pmr7c9/OOS/README.md

# OOS
	OOS - optyczny odbiornik sygnałów
	Urządzenie do odbioru sygnału optycznego i konwersję na sygnał elektryczny.
