pmr7c9/OOS/Pictures/AOSS32334C_Static_Parameters.jpg

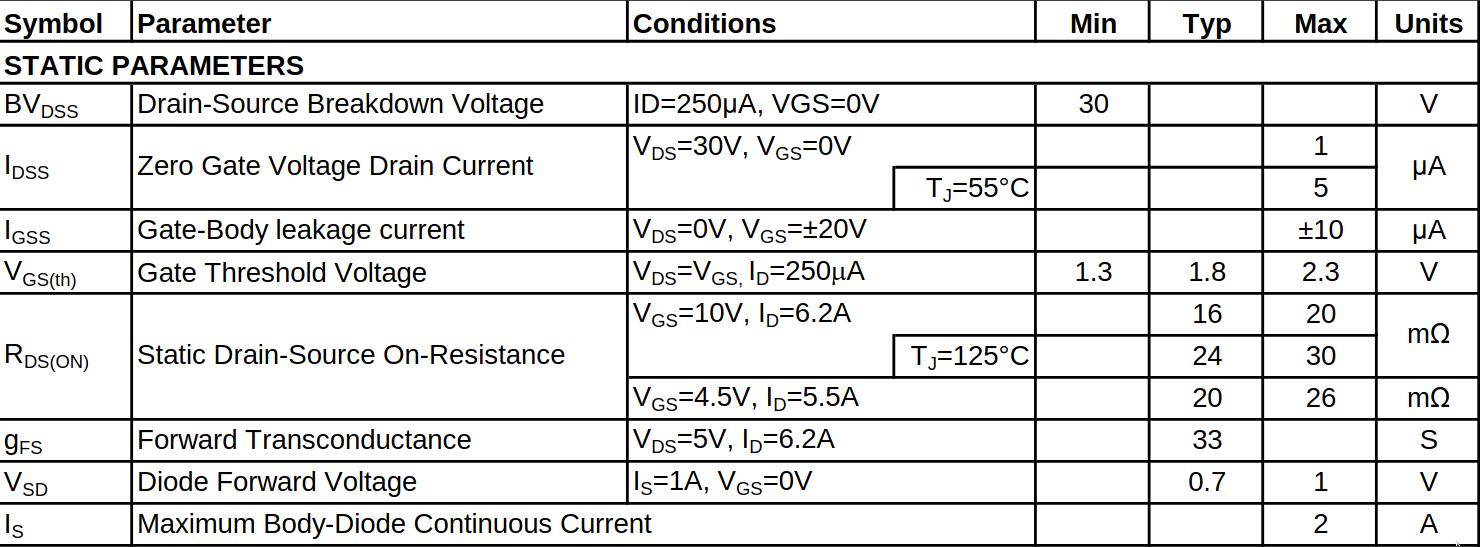
Pictures/AOSS32334C_Static_Parameters.jpg
