pmr7c9/OOS/Pictures/MCP73832_PROG.jpg

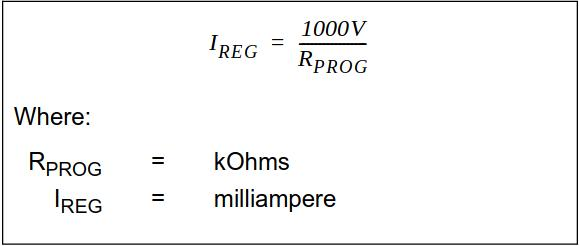
Pictures/MCP73832_PROG.jpg
