pmr7c9/OOS/OOS - optyczny odbiornik sygnalow/rotary_switch/SR17A1815F89N.stp

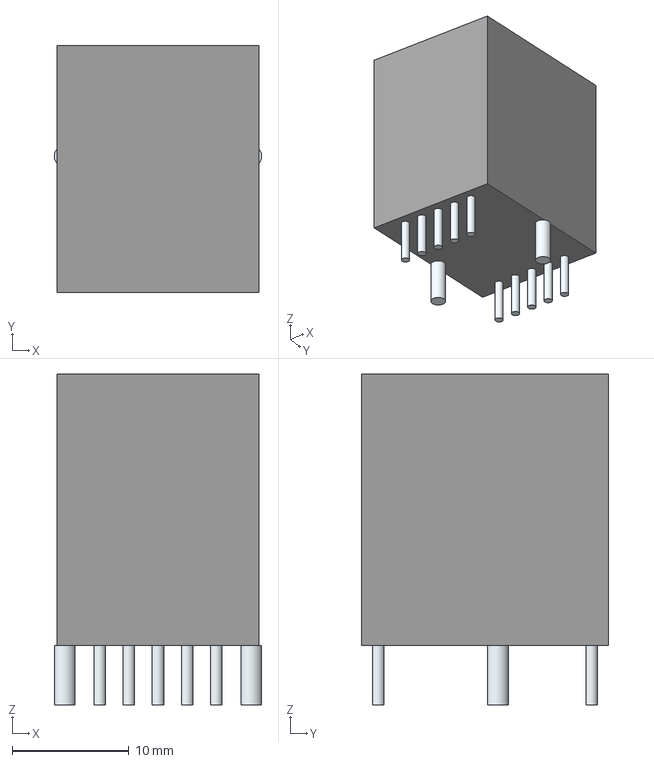
[picture p3: CAD file, 2025-11-27]
OOS - optyczny odbiornik sygnalow/rotary_switch/SR17A1815F89N.stp
17.8 x 21.2 x 28.4 mm
Leads x 12
