pmr7c9/OOS/OOS - optyczny odbiornik sygnalow/OOS - optyczny odbiornik sygnalow.kicad_pcb

## KiCad design OOS - optyczny odbiornik sygnalow/OOS - optyczny odbiornik sygnalow.kicad_pcb (2025-11-28)

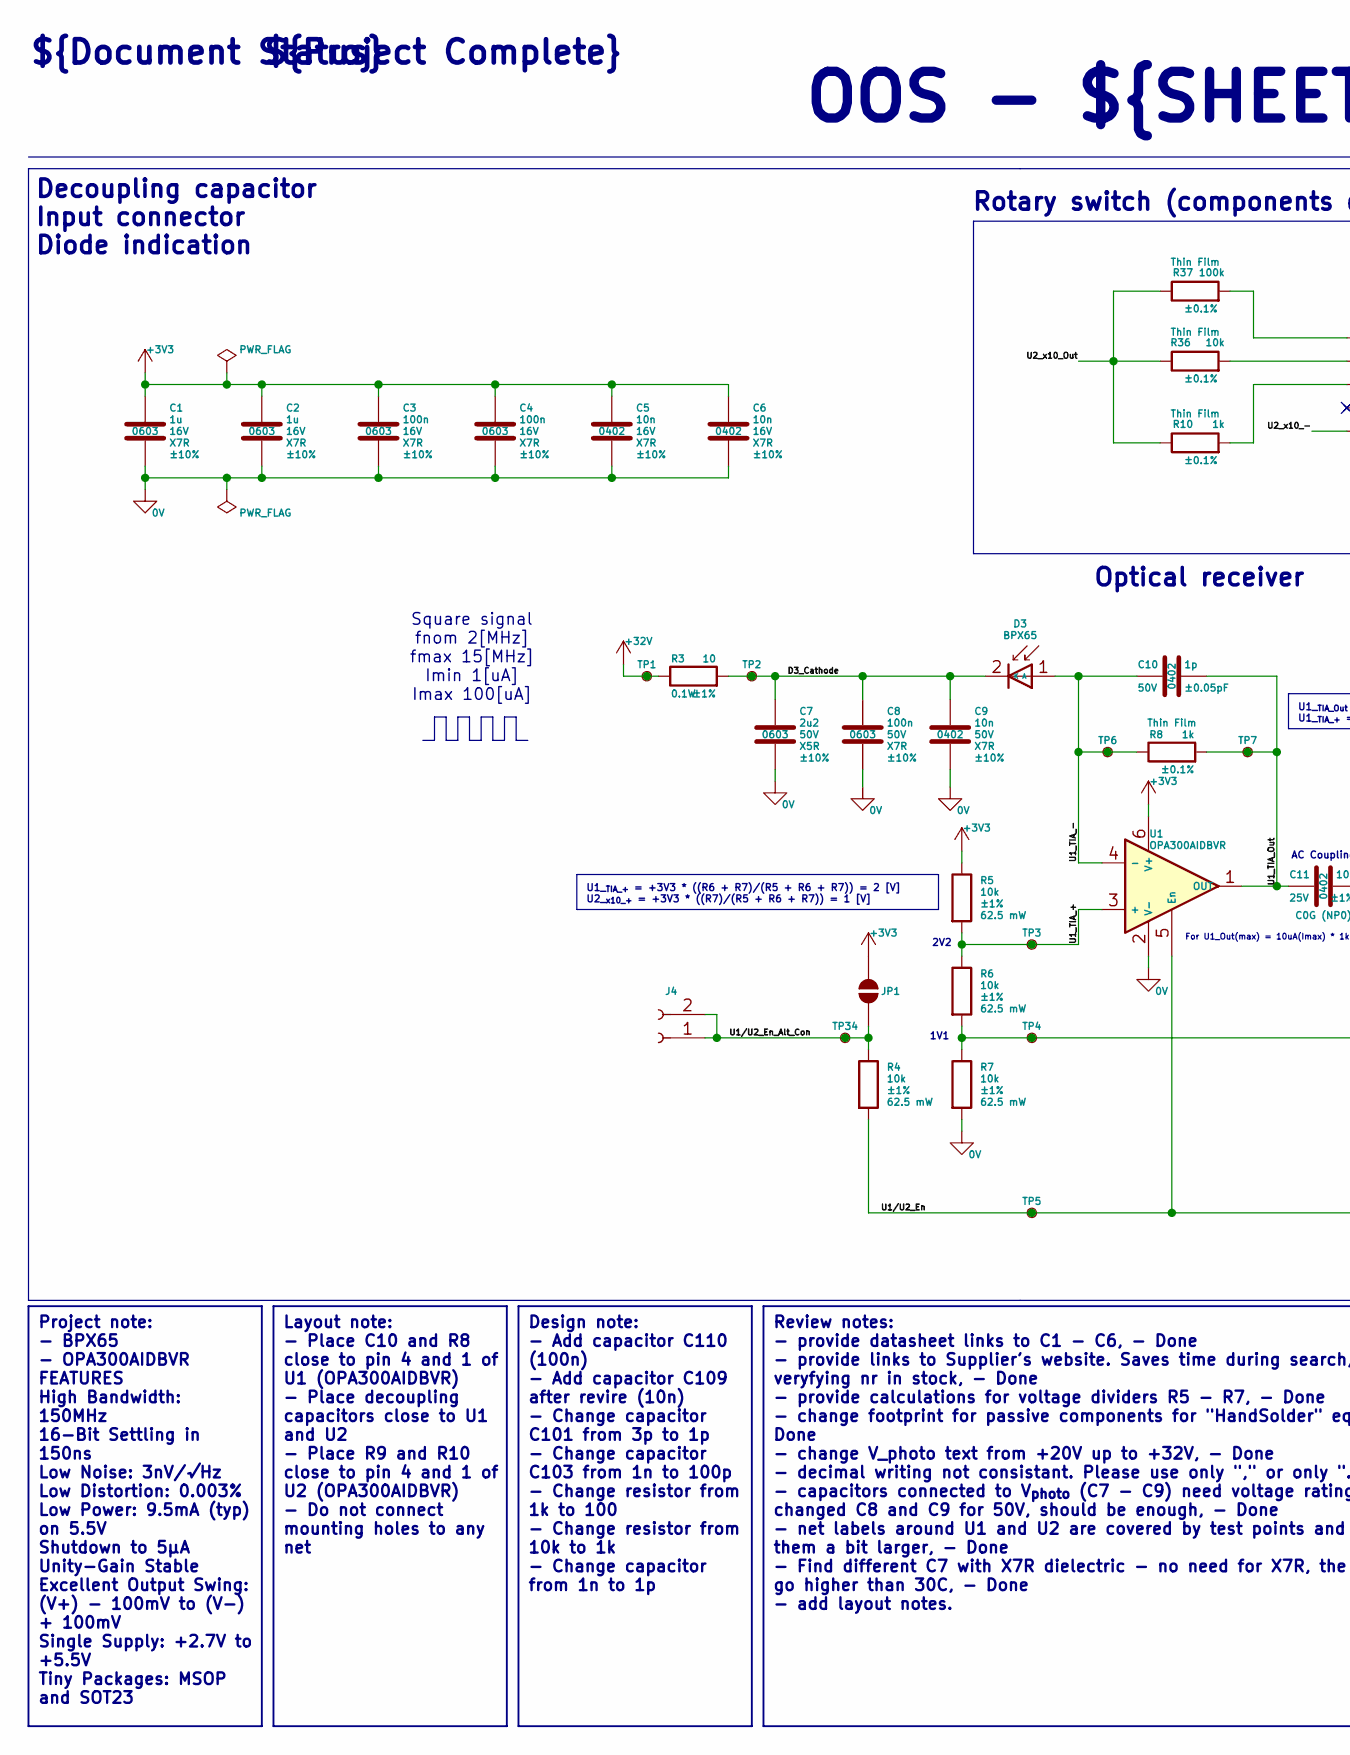
[picture p4: schematic Sekcja_Analogowa.kicad_sch, ${Project Title}, part in row 1, column 1]

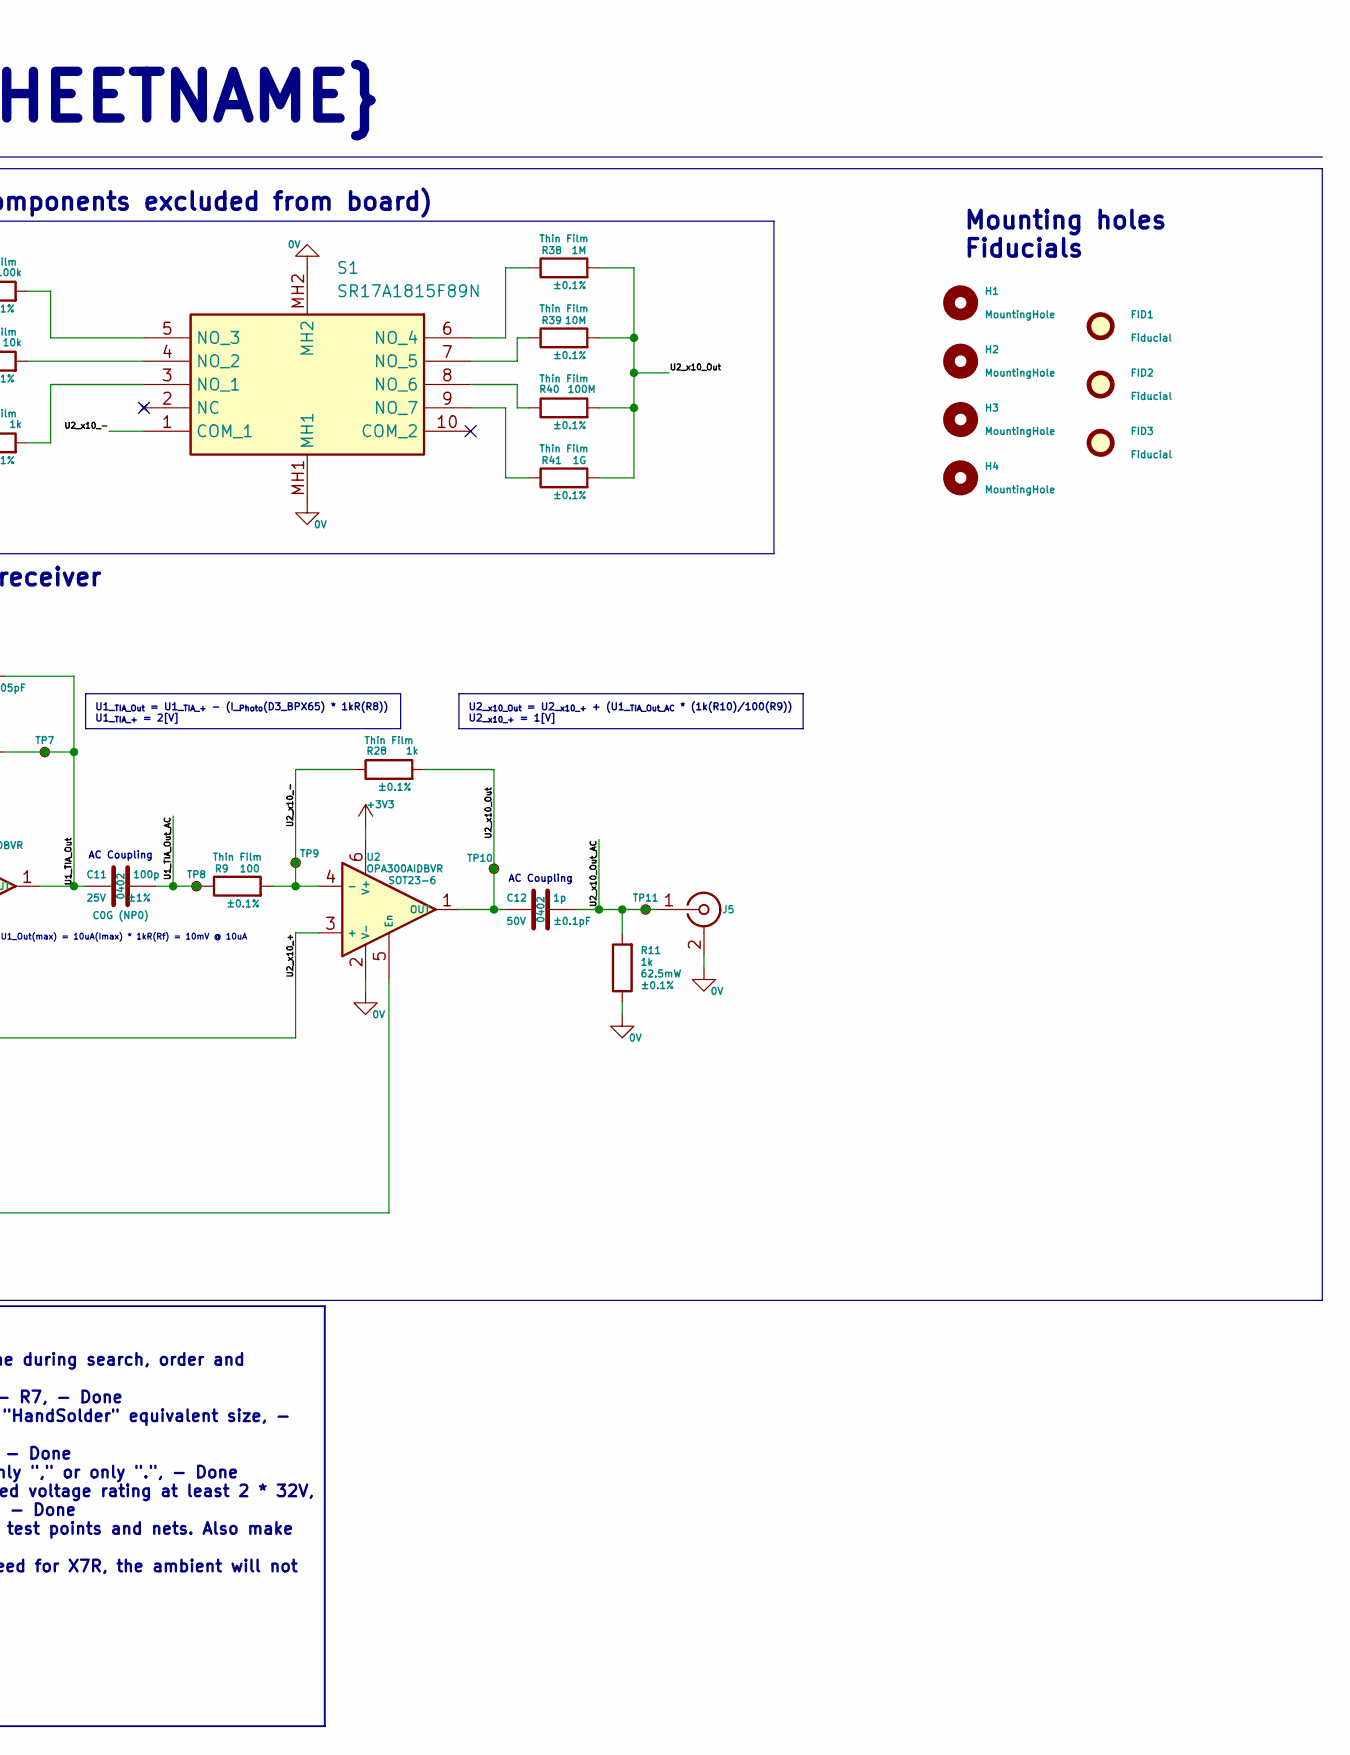
[picture p5: schematic Sekcja_Analogowa.kicad_sch, ${Project Title}, part in row 1, column 2]

Parts:
C1, C2: 1u; C_0603_1608Metric_Pad1.08x0.95mm_HandSolder; Voltage Rating 16V; Tolerance ±10%; MPN CC0603KRX7R7BB105
C3, C4: 100n; C_0603_1608Metric_Pad1.08x0.95mm_HandSolder; Voltage Rating 16V; Tolerance ±10%; MPN CL10B104KO8WPNC
C5, C6: 10n; C_0402_1005Metric_Pad0.74x0.62mm_HandSolder; Voltage Rating 16V; Tolerance ±10%; MPN CL05B103KO5NNNC
C7: 2u2; C_0603_1608Metric_Pad1.08x0.95mm_HandSolder; Voltage Rating 50V; Tolerance ±10%; MPN GRT188R61H225KE13D
C8: 100n; C_0603_1608Metric_Pad1.08x0.95mm_HandSolder; Voltage Rating 50V; Tolerance ±10%; MPN CGA3E2X7R1H104KAA
C9: 10n; C_0402_1005Metric_Pad0.74x0.62mm_HandSolder; Voltage Rating 50V; Tolerance ±10%; MPN CL05B103KB5NNND
C10: 1p; C_0402_1005Metric_Pad0.74x0.62mm_HandSolder; Voltage Rating 50V; Tolerance ±0.05pF; MPN GCM1555C1H1R0BA16D
C11: 100p; C_0402_1005Metric_Pad0.74x0.62mm_HandSolder; Voltage Rating 25V; Tolerance ±1%; MPN GRM0225C1E101GA02L
C12: 1p; C_0402_1005Metric_Pad0.74x0.62mm_HandSolder; Voltage Rating 50V; Tolerance ±0.1pF; MPN GCM1555C1H1R0BA16D
D3: BPX65; TO-18-2_Lens; MPN BPX65
FID1, FID2, FID3: Fiducial; Fiducial_1.5mm_Mask3mm
H1, H2, H3, H4: MountingHole; MountingHole_3.2mm_M3
J4: Conn_01x02_Socket; PinHeader_1x02_P2.54mm_Vertical
J5: Conn_Coaxial; BNC_Amphenol_B6252HB-NPP3G-50_Horizontal; MPN R-128
JP1: SolderJumper_2_Open; SolderJumper-2_P1.3mm_Open_RoundedPad1.0x1.5mm
R3: 10; R_0603_1608Metric_Pad0.98x0.95mm_HandSolder; Power Rating 0.1W; Tolerance ±1%; MPN RCA060310R0FKEA
R4, R5, R6, R7: 10k; R_0402_1005Metric_Pad0.72x0.64mm_HandSolder; Power Rating 62.5 mW; Tolerance ±1%; MPN WR04X1002FTL
R8, R10, R11, R28: 1k; R_0402_1005Metric_Pad0.72x0.64mm_HandSolder; Power Rating 62.5mW; Tolerance ±0.1%; MPN RT0402BRD071KL
R9: 100; R_0402_1005Metric_Pad0.72x0.64mm_HandSolder; Power Rating 62.5mW; Tolerance ±0.1%; MPN ERA2AEB101X
R36: 10k; R_0402_1005Metric_Pad0.72x0.64mm_HandSolder; Power Rating 62.5mW; Tolerance ±0.1%; MPN RT0402BRD071KL
R37: 100k; R_0402_1005Metric_Pad0.72x0.64mm_HandSolder; Power Rating 62.5mW; Tolerance ±0.1%; MPN RT0402BRD071KL
R38: 1M; R_0402_1005Metric_Pad0.72x0.64mm_HandSolder; Power Rating 62.5mW; Tolerance ±0.1%; MPN RT0402BRD071KL
R39: 10M; R_0402_1005Metric_Pad0.72x0.64mm_HandSolder; Power Rating 62.5mW; Tolerance ±0.1%; MPN RT0402BRD071KL
R40: 100M; R_0402_1005Metric_Pad0.72x0.64mm_HandSolder; Power Rating 62.5mW; Tolerance ±0.1%; MPN RT0402BRD071KL
R41: 1G; R_0402_1005Metric_Pad0.72x0.64mm_HandSolder; Power Rating 62.5mW; Tolerance ±0.1%; MPN RT0402BRD071KL
S1: SR17A1815F89N; Manufacturer_Part_Number SR17A1815F89N
TP1, TP2, TP3, TP4, TP5, TP6, TP7, TP8, TP9, TP10, TP11, TP34: TestPoint_Small; TestPoint_Pad_D1.0mm
U1, U2: OPA300AIDBVR; SOT-23-6_Handsoldering; MPN OPA300AIDBVR

Connections:
0V: C1.2, C2.2, C3.2, C4.2, C5.2, C6.2, C7.1, C8.2, C9.2, J5.2 (Ext), R7.2, R11.1, S1.MH1, S1.MH2, U1.2 (V-), U2.2 (V-); also elsewhere on the board
+3V3: C1.1, C2.1, C3.1, C4.1, C5.1, C6.1, JP1.2 (B), R5.1, U1.6 (V+), U2.6 (V+); also elsewhere on the board
+32V: R3.1, TP1.1; also elsewhere on the board
/Sekcja_Analogowa/D3_Cathode: C7.2, C8.1, C9.1, D3.2 (K), R3.2, TP2.1
/Sekcja_Analogowa/U1_TIA_+: R5.2, R6.1, TP3.1, U1.3 (+)
/Sekcja_Analogowa/U1_TIA_-: C10.1, D3.1 (A), R8.1, TP6.1, U1.4 (-)
/Sekcja_Analogowa/U1_TIA_Out: C10.2, C11.1, R8.2, TP7.1, U1.1 (OUT)
/Sekcja_Analogowa/U1_TIA_Out_AC: C11.2, R9.1, TP8.1
/Sekcja_Analogowa/U1/U2_En: R4.2, TP5.1, U1.5 (En), U2.5 (En)
/Sekcja_Analogowa/U1/U2_En_Alt_Con: J4.1, J4.2, JP1.1 (A), R4.1, TP34.1
/Sekcja_Analogowa/U2_x10_+: R6.2, R7.1, TP4.1, U2.3 (+)
/Sekcja_Analogowa/U2_x10_-: R9.2, R28.1, S1.1 (COM_1), TP9.1, U2.4 (-)
/Sekcja_Analogowa/U2_x10_Out: C12.1, R10.1, R28.2, R36.1, R37.1, R38.2, R39.2, R40.2, R41.2, TP10.1, U2.1 (OUT)
/Sekcja_Analogowa/U2_x10_Out_AC: C12.2, J5.1 (In), R11.2, TP11.1
unnamed: R10.2, S1.3 (NO_1)
unnamed: R36.2, S1.4 (NO_2)
unnamed: R37.2, S1.5 (NO_3)
unnamed: R38.1, S1.6 (NO_4)
unnamed: R39.1, S1.7 (NO_5)
unnamed: R40.1, S1.8 (NO_6)
unnamed: R41.1, S1.9 (NO_7)

Notes on the sheet:
Square signal fnom 2[MHz] fmax 15[MHz] Imin 1[uA] Imax 100[uA]
For U1_Out(max) = 10uA(Imax) * 1kR(Rf) = 10mV @ 10uA
Mounting holes Fiducials
AC Coupling
1V1
${Project Complete}
${Document Status}
Decoupling capacitor Input connector Diode indication
OOS - ${SHEETNAME}
2V2
Optical receiver
Rotary switch (components excluded from board)
Review notes: - provide datasheet links to C1 - C6, - Done - provide links to Supplier's website. Saves time during search, order and veryfying nr in stock, - Done - provide calculations for voltage dividers R5 - R7, - Done - change footprint for passive components for "HandSolder" equivalent size,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
U2__{x10_Out} = U2__{x10_+} + (U1__{TIA_Out_AC} * (1k(R10)/100(R9)) U2__{x10_+} = 1[V]
Design note: - Add capacitor C110 (100n) - Add capacitor C109 after revire (10n) - Change capacitor C101 from 3p to 1p - Change capacitor C103 from 1n to 100p - Change resistor from 1k to 100 - Change resistor from 10k to 1k - Change capacitor from 1n to 1p
U1__{TIA_+} = +3V3 * ((R6 + R7)/(R5 + R6 + R7)) = 2 [V] U2__{x10_+} = +3V3 * ((R7)/(R5 + R6 + R7)) = 1 [V]
U1__{TIA_Out} = U1__{TIA_+} - (I__{Photo}(D3_BPX65) * 1kR(R8)) U1__{TIA_+} = 2[V]
Layout note: - Place C10 and R8 close to pin 4 and 1 of U1 (OPA300AIDBVR) - Place decoupling capacitors close to U1 and U2 - Place R9 and R10 close to pin 4 and 1 of U2 (OPA300AIDBVR) - Do not connect mounting holes to any net
Project note: - BPX65 - OPA300AIDBVR FEATURES High Bandwidth: 150MHz 16-Bit Settling in 150ns Low Noise: 3nV/√Hz Low Distortion: 0.003% Low Power: 9.5mA (typ) on 5.5V Shutdown to 5μA Unity-Gain Stable Excellent Output Swing: (V+) − 100mV to (V−) + 100mV Single Supply: +2.7V to +5.5V Tiny Packages: 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

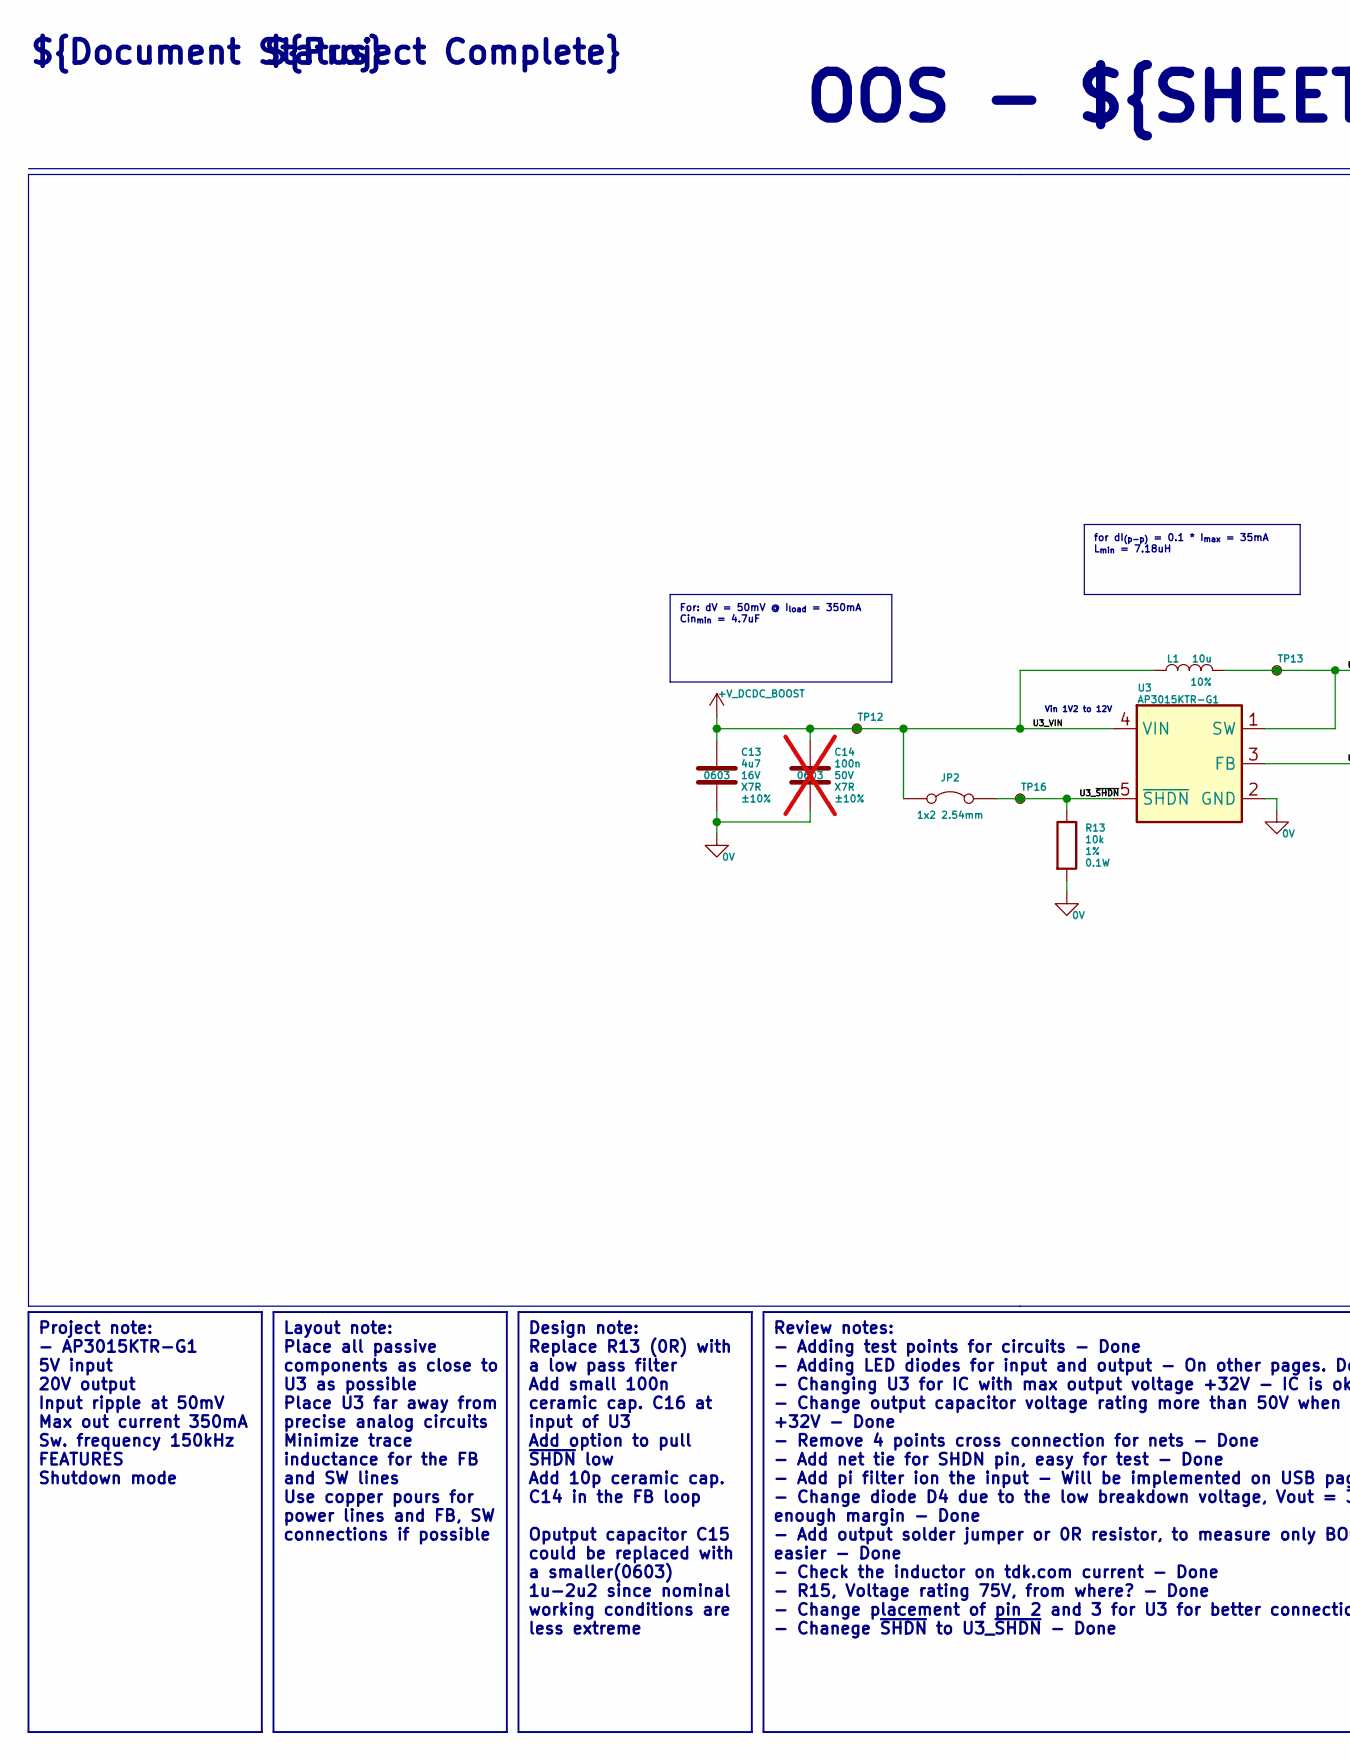
[picture p6: schematic Sekcja_DCDC_Boost.kicad_sch, ${Project Title}, part in row 1, column 1]

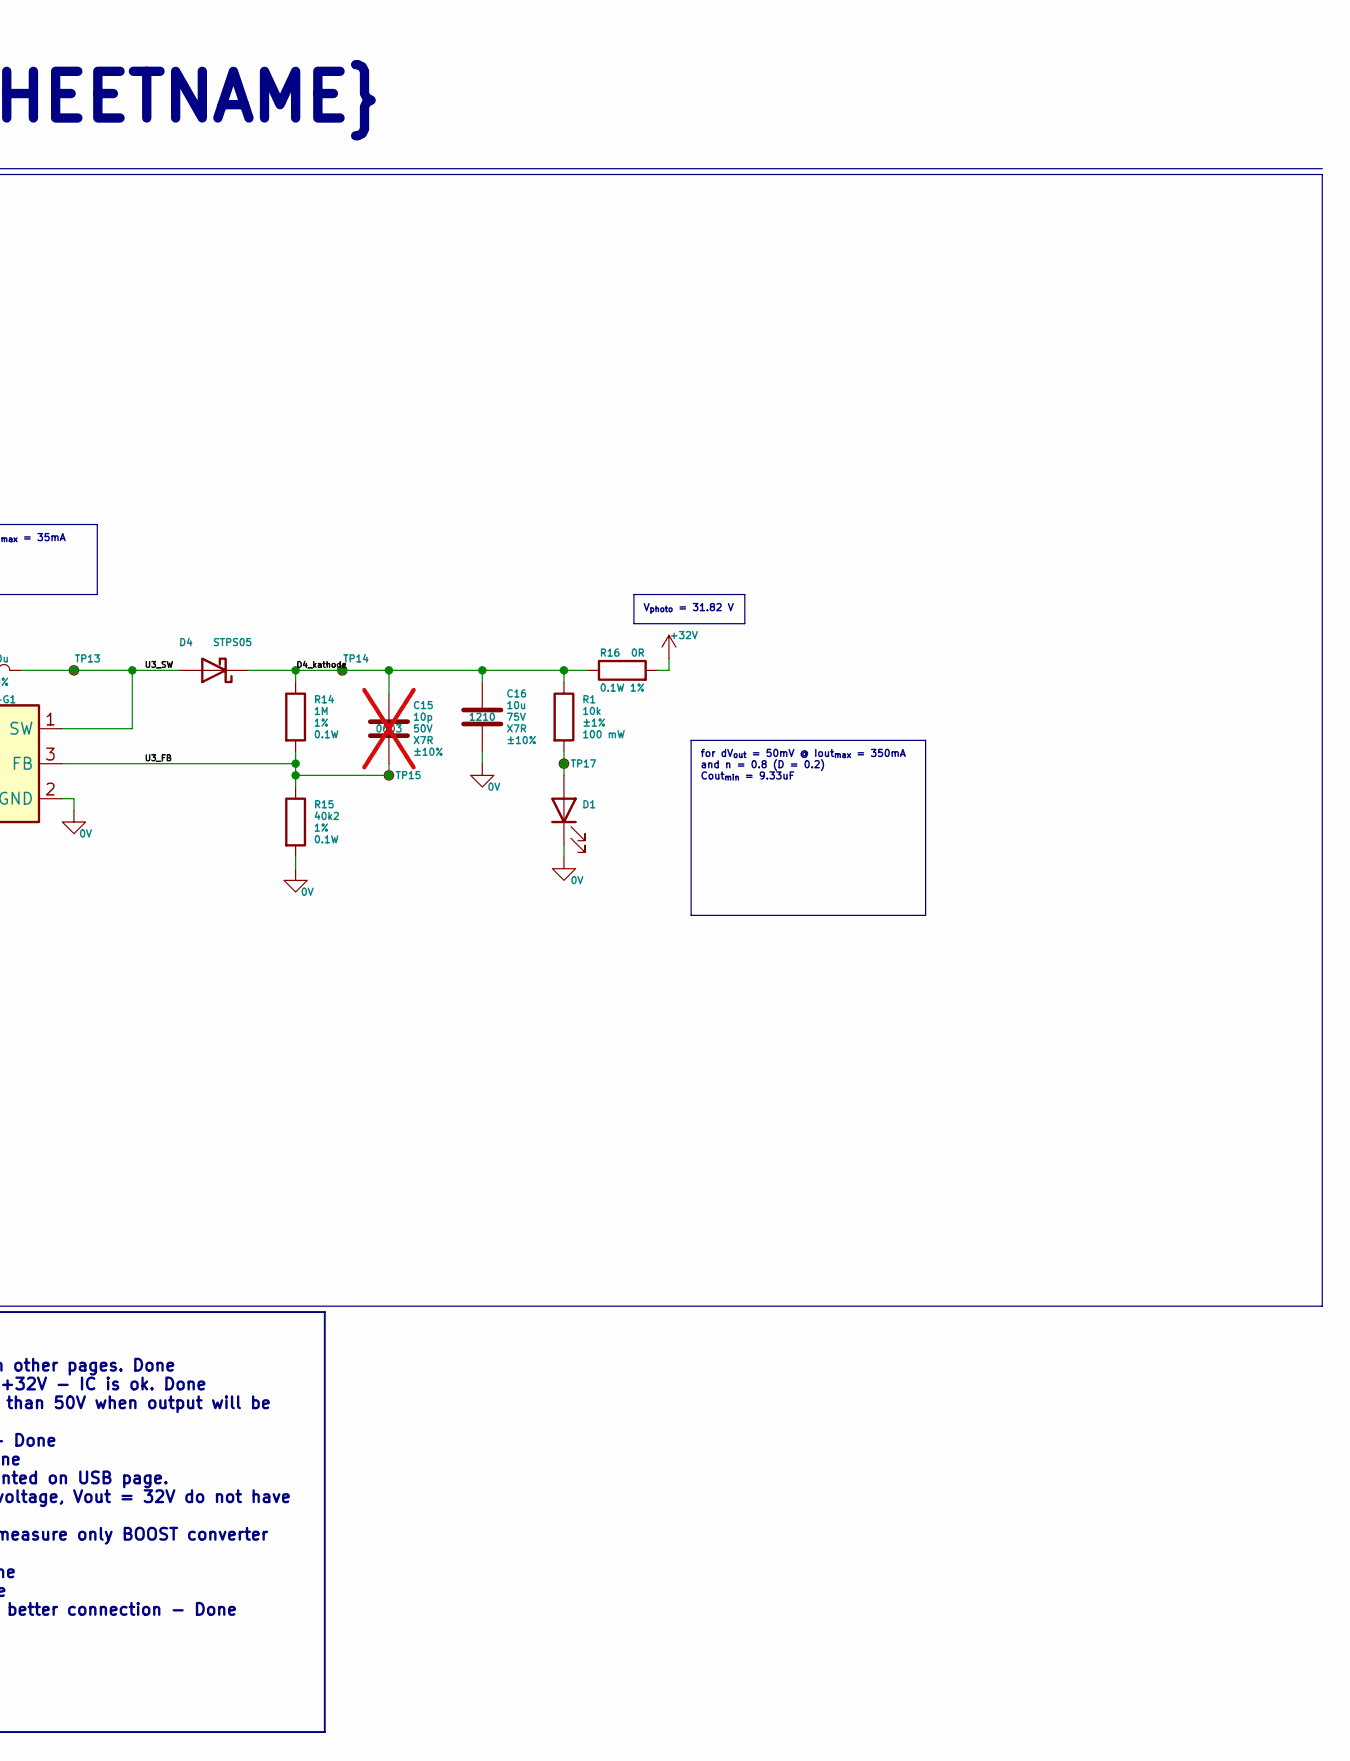
[picture p7: schematic Sekcja_DCDC_Boost.kicad_sch, ${Project Title}, part in row 1, column 2]

Parts:
C13: 4u7; C_0603_1608Metric; Voltage Rating 16V; Tolerance ±10%
C14: 100n; C_0603_1608Metric; Voltage Rating 50V; Tolerance ±10%; not fitted
C15: 10p; C_0603_1608Metric; Voltage Rating 50V; Tolerance ±10%; not fitted
C16: 10u; C_1210_3225Metric_Pad1.33x2.70mm_HandSolder; Voltage Rating 75V; Tolerance ±10%
D1: LED; D_0603_1608Metric_Pad1.05x0.95mm_HandSolder; MPN LTST-C191KGKT
D4: STPS05; Nexperia_CFP3_SOD-123W
JP2: 1x2 2.54mm; PinHeader_1x02_P2.54mm_Vertical
L1: 10u; L_1210_3225Metric_Pad1.42x2.65mm_HandSolder; Tolerance 10%
R1: 10k; R_0603_1608Metric_Pad0.98x0.95mm_HandSolder; Power Rating 100 mW; Tolerance ±1%; MPN RC0603FR-0710K
R13: 10k; R_0603_1608Metric; Power Rating 0.1W; Tolerance 1%
R14: 1M; R_0603_1608Metric; Power Rating 0.1W; Tolerance 1%
R15: 40k2; R_0603_1608Metric; Power Rating 0.1W; Tolerance 1%
R16: 0R; R_0603_1608Metric; Power Rating 0.1W; Tolerance 1%
TP12, TP13, TP14, TP15, TP16, TP17: TestPoint_Small; TestPoint_Pad_D1.0mm
U3: AP3015KTR-G1; SOT-23-5_HandSoldering

Connections:
0V: C13.2, C14.2, C16.2, D1.1 (K), R13.2, R15.2, U3.2 (GND); also elsewhere on the board
+32V: R16.2; also elsewhere on the board
+V_DCDC_BOOST: C13.1, C14.1, JP2.1 (A), L1.1, TP12.1, U3.4 (VIN); also elsewhere on the board
/Sekcja_DCDC_Boost/D4_kathode: C15.1, C16.1, D4.1 (K), R1.1, R14.1, R16.1, TP14.1
/Sekcja_DCDC_Boost/U3_FB: C15.2, R14.2, R15.1, TP15.1, U3.3 (FB)
/Sekcja_DCDC_Boost/U3_SW: D4.2 (A), L1.2, TP13.1, U3.1 (SW)
/Sekcja_DCDC_Boost/U3_~SHDN: JP2.2 (B), R13.1, TP16.1, U3.5 (~SHDN)
unnamed: D1.2 (A), R1.2, TP17.1

Notes on the sheet:
${Document Status}
Vin 1V2 to 12V
OOS - ${SHEETNAME}
${Project Complete}
for dV_{out} = 50mV @ Iout_{max} = 350mA and n = 0.8 (D = 0.2) Cout_{min} = 9.33uF
Project note: - AP3015KTR-G1 5V input 20V output Input ripple at 50mV Max out current 350mA Sw. frequency 150kHz FEATURES Shutdown mode
V_{photo} = 31.82 V
Layout note: Place all passive components as close to U3 as possible Place U3 far away from precise analog circuits Minimize trace inductance for the FB and SW lines Use copper pours for power lines and FB, SW connections if possible
For: dV = 50mV @ I_{load} = 350mA Cin_{min} = 4.7uF
for dI_{(p-p)} = 0.1 * I_{max} = 35mA L_{min} = 7.18uH
Design note: Replace R13 (0R) with a low pass filter Add small 100n ceramic cap. C16 at input of U3 Add option to pull ~{SHDN} low Add 10p ceramic cap. C14 in the FB loop Oputput capacitor C15 could be replaced with a smaller(0603) 1u-2u2 since nominal working conditions are less extreme
Review notes: - Adding test points for circuits - Done - Adding LED diodes for input and output - On other pages. Done - Changing U3 for IC with max output voltage +32V - IC is ok. Done - Change output capacitor voltage rating more than 50V when output will be +32V - Done - Remove 4 points cross co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

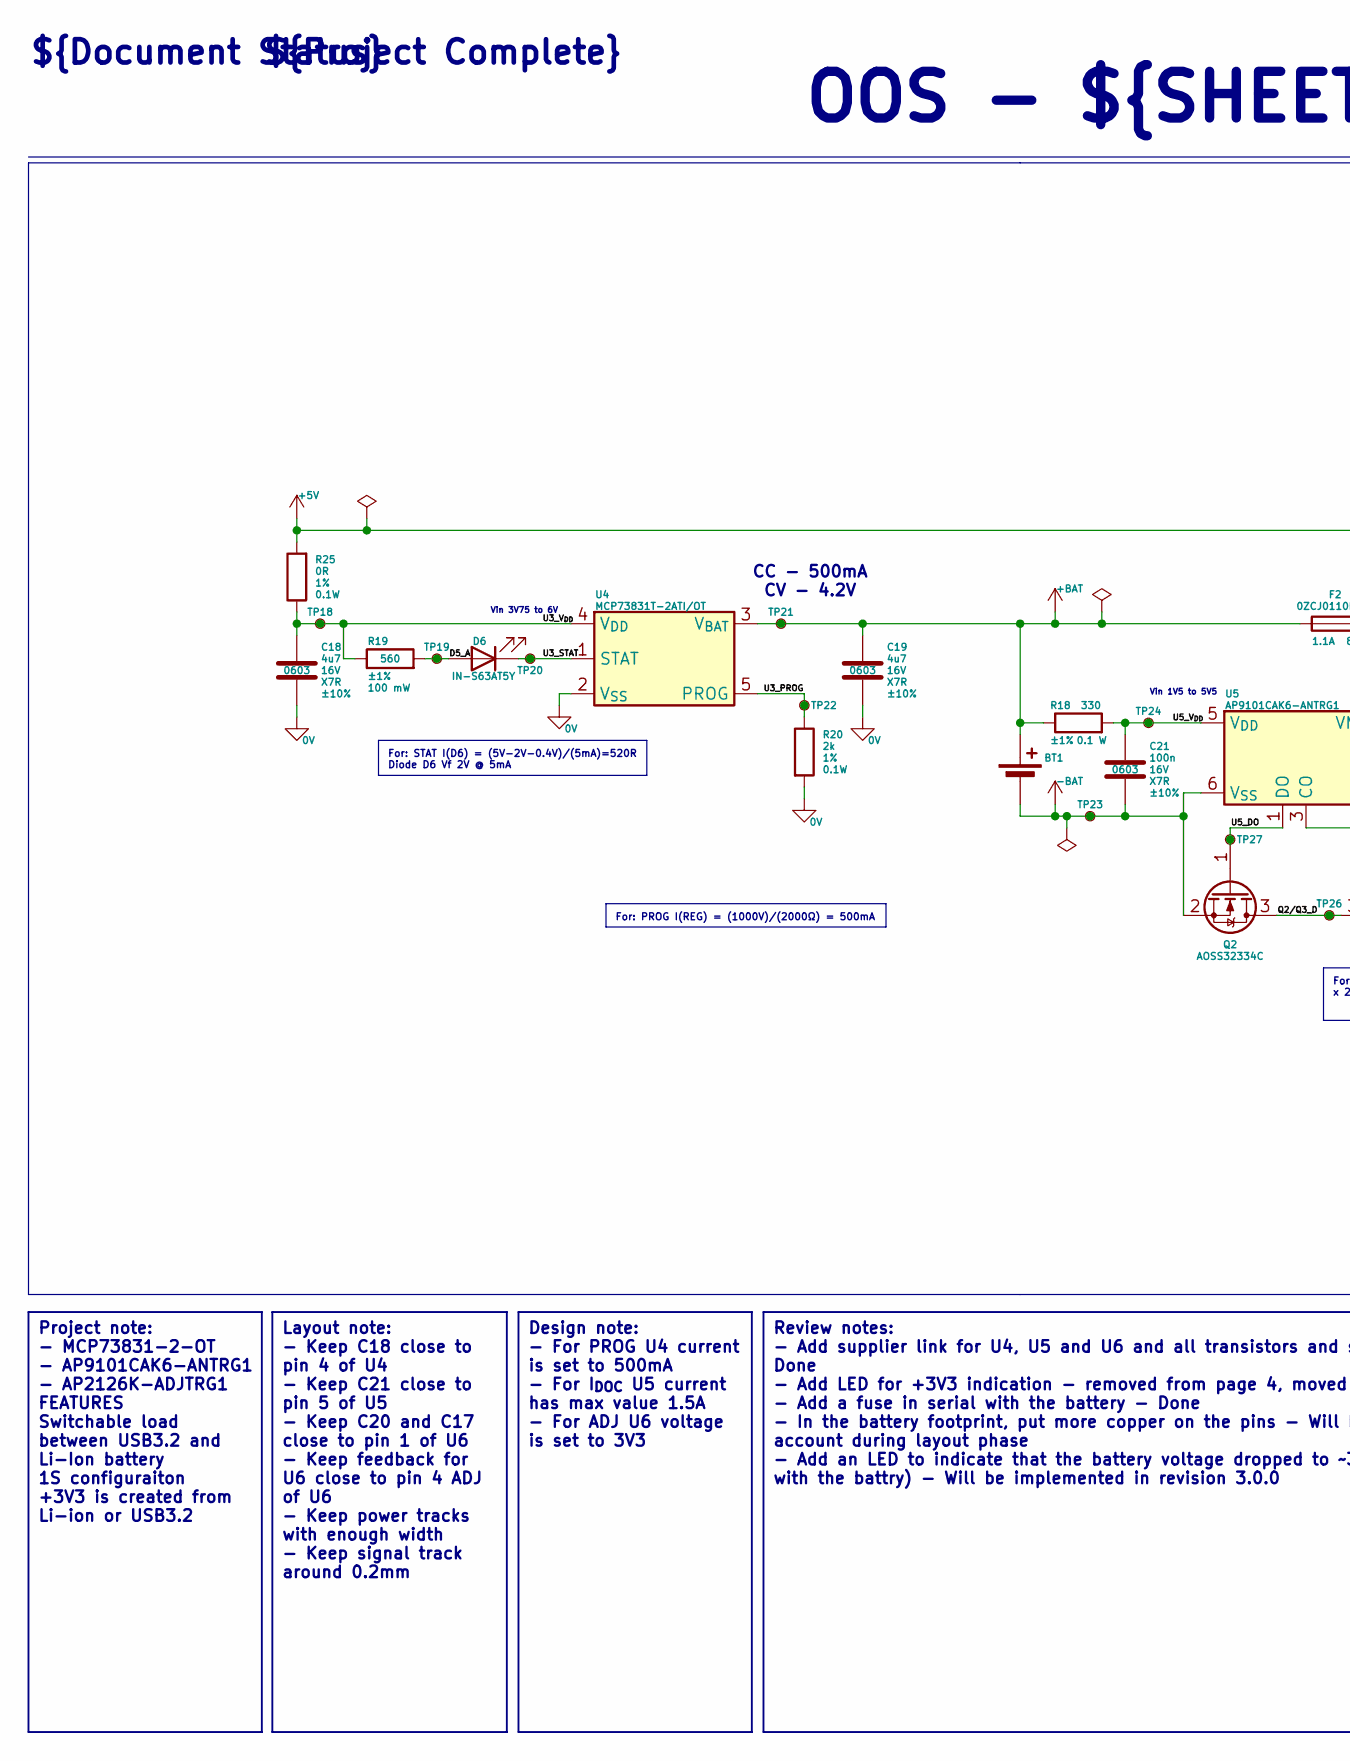
[picture p8: schematic Sekcja_Li-ion_Ladowanie.kicad_sch, ${Project Title}, part in row 1, column 1]

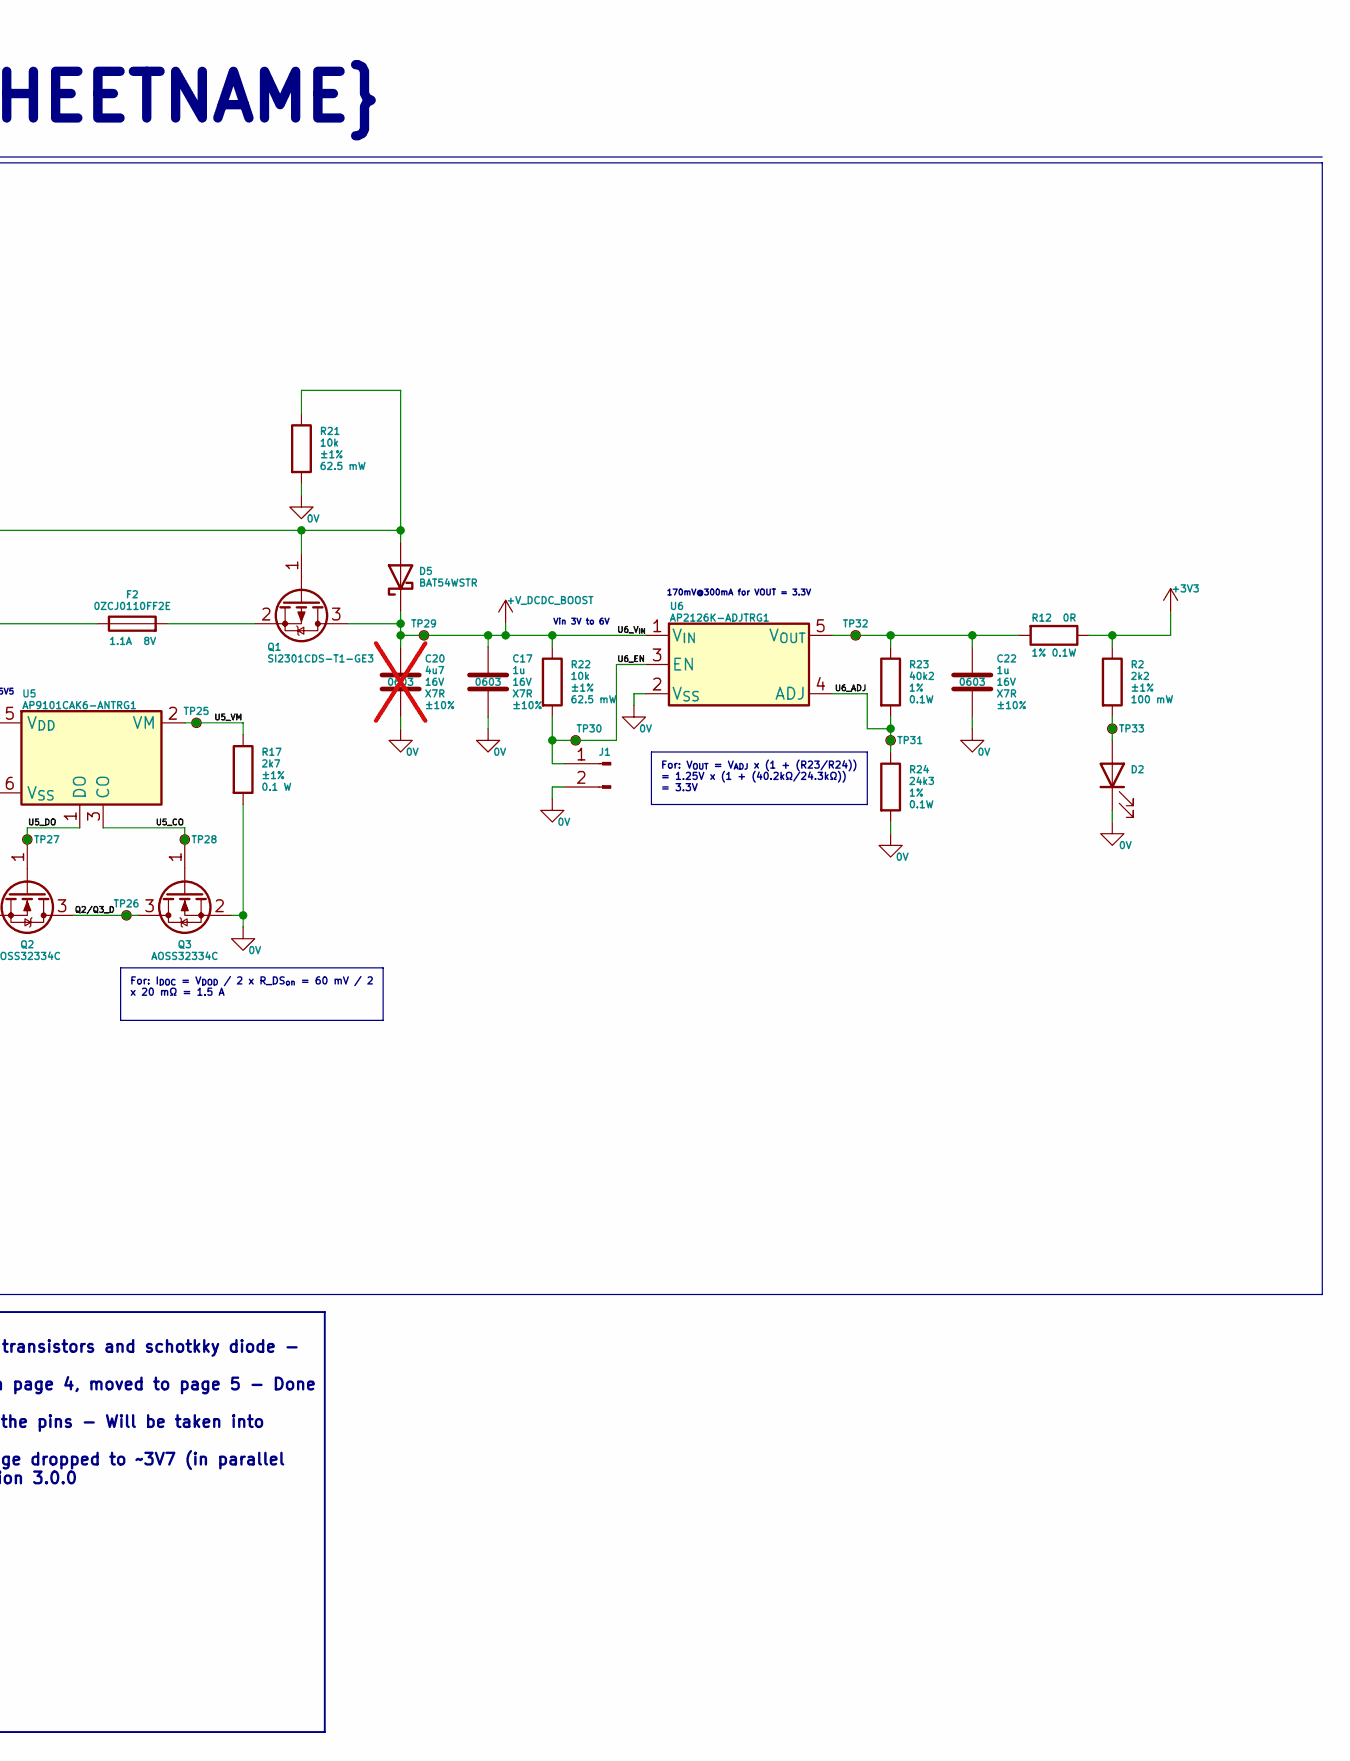
[picture p9: schematic Sekcja_Li-ion_Ladowanie.kicad_sch, ${Project Title}, part in row 1, column 2]

Parts:
BT1: Battery_Cell; BatteryHolder_MPD_BH-18650-PC2
C17, C22: 1u; C_0603_1608Metric_Pad1.08x0.95mm_HandSolder; Voltage Rating 16V; Tolerance ±10%; MPN CC0603KRX7R7BB105
C18, C19: 4u7; C_0603_1608Metric; Voltage Rating 16V; Tolerance ±10%
C20: 4u7; C_0603_1608Metric; Voltage Rating 16V; Tolerance ±10%; not fitted
C21: 100n; C_0603_1608Metric_Pad1.08x0.95mm_HandSolder; Voltage Rating 16V; Tolerance ±10%; MPN CL10B104KO8WPNC
D2: LED; D_0603_1608Metric_Pad1.05x0.95mm_HandSolder; MPN LTST-C191KGKT
D5: BAT54WSTR; D_SOD-323
D6: LED; D_0603_1608Metric_Pad1.05x0.95mm_HandSolder; MPN IN-S63AT5Y
F2: 0ZCJ0110FF2E; Fuse_1206_3216Metric; Max Voltage 8V
J1: Conn_01x02_Pin; PinHeader_1x02_P2.54mm_Vertical
Q1: SI2301CDS-T1-GE3; SOT-23_Handsoldering
Q2, Q3: AOSS32334C; SOT-23
R2: 2k2; R_0603_1608Metric_Pad0.98x0.95mm_HandSolder; Power Rating 100 mW; Tolerance ±1%; MPN AC0603FR-072K2L
R12, R25: 0R; R_0603_1608Metric; Power Rating 0.1W; Tolerance 1%
R17: 2k7; R_0603_1608Metric_Pad0.98x0.95mm_HandSolder; Power Rating 0.1 W; Tolerance ±1%; MPN ERJ3EKF2701V
R18: 330; R_0603_1608Metric_Pad0.98x0.95mm_HandSolder; Power Rating 0.1 W; Tolerance ±1%; MPN RC0603FR-07330RL
R19: 560; R_0603_1608Metric_Pad0.98x0.95mm_HandSolder; Power Rating 100 mW; Tolerance ±1%; MPN WR06X5600FTL
R20: 2k; R_0603_1608Metric_Pad0.98x0.95mm_HandSolder; Power Rating 0.1W; Tolerance 1%
R21, R22: 10k; R_0402_1005Metric_Pad0.72x0.64mm_HandSolder; Power Rating 62.5 mW; Tolerance ±1%; MPN WR04X1002FTL
R23: 40k2; R_0603_1608Metric; Power Rating 0.1W; Tolerance 1%
R24: 24k3; R_0603_1608Metric; Power Rating 0.1W; Tolerance 1%; MPN ERJ3EKF2432V
TP18, TP19, TP20, TP21, TP22, TP23, TP24, TP25, TP26, TP27, TP28, TP29, TP30, TP31, TP32, TP33: TestPoint_Small; TestPoint_Pad_D1.0mm
U4: MCP73831T-2ATI/OT; SOT-23-5
U5: AP9101CAK6-ANTRG1; SOT-23-6
U6: AP2126K-ADJTRG1; SOT-23-5_HandSoldering

Connections:
0V: C17.2, C18.2, C19.2, C20.2, C22.2, D2.1 (K), J1.2, Q3.2 (S), R17.2, R20.2, R21.2, R24.2, U4.2 (V_{SS}), U6.2 (V_{SS}); also elsewhere on the board
+3V3: R2.1, R12.1; also elsewhere on the board
+5V: D5.2 (A), Q1.1 (G), R21.1, R25.2; also elsewhere on the board
+BAT: BT1.1 (+), C19.1, F2.1, R18.1, TP21.1, U4.3 (V_{BAT})
+V_DCDC_BOOST: C17.1, C20.1, D5.1 (K), Q1.3 (D), R22.1, TP29.1, U6.1 (V_{IN}); also elsewhere on the board
-BAT: BT1.2 (-), C21.2, Q2.2 (S), TP23.1, U5.6 (V_{SS})
/Sekcja_Li-ion_Ladowanie/D5_A: D6.2 (A), R19.2, TP19.1
/Sekcja_Li-ion_Ladowanie/Q2/Q3_D: Q2.3 (D), Q3.3 (D), TP26.1
/Sekcja_Li-ion_Ladowanie/U3_PROG: R20.1, TP22.1, U4.5 (PROG)
/Sekcja_Li-ion_Ladowanie/U3_STAT: D6.1 (K), TP20.1, U4.1 (STAT)
/Sekcja_Li-ion_Ladowanie/U3_V_{DD}: C18.1, R19.1, R25.1, TP18.1, U4.4 (V_{DD})
/Sekcja_Li-ion_Ladowanie/U5_CO: Q3.1 (G), TP28.1, U5.3 (CO)
/Sekcja_Li-ion_Ladowanie/U5_DO: Q2.1 (G), TP27.1, U5.1 (DO)
/Sekcja_Li-ion_Ladowanie/U5_VM: R17.1, TP25.1, U5.2 (VM)
/Sekcja_Li-ion_Ladowanie/U5_V_{DD}: C21.1, R18.2, TP24.1, U5.5 (V_{DD})
/Sekcja_Li-ion_Ladowanie/U6_ADJ: R23.2, R24.1, TP31.1, U6.4 (ADJ)
/Sekcja_Li-ion_Ladowanie/U6_EN: J1.1, R22.2, TP30.1, U6.3 (EN)
unnamed: D2.2 (A), R2.2, TP33.1
unnamed: F2.2, Q1.2 (S)
unnamed: C22.1, R12.2, R23.1, TP32.1, U6.5 (V_{OUT})

Notes on the sheet:
${Document Status}
Vin 1V5 to 5V5
Vin 3V to 6V
OOS - ${SHEETNAME}
Vin 3V75 to 6V
CC - 500mA CV - 4.2V
170mV@300mA for VOUT = 3.3V
${Project Complete}
Project note: - MCP73831-2-OT - AP9101CAK6-ANTRG1 - AP2126K-ADJTRG1 FEATURES Switchable load between USB3.2 and Li-Ion battery 1S configuraiton +3V3 is created from Li-ion or USB3.2
For: PROG I(REG) = (1000V)/(2000Ω) = 500mA
For: STAT I(D6) = (5V-2V-0.4V)/(5mA)=520R Diode D6 Vf 2V @ 5mA
For: I_{DOC} = V_{DOD} / 2 x R_DS_{on} = 60 mV / 2 x 20 mΩ = 1.5 A
Design note: - For PROG U4 current is set to 500mA - For I_{DOC} U5 current has max value 1.5A - For ADJ U6 voltage is set to 3V3
Layout note: - Keep C18 close to pin 4 of U4 - Keep C21 close to pin 5 of U5 - Keep C20 and C17 close to pin 1 of U6 - Keep feedback for U6 close to pin 4 ADJ of U6 - Keep power tracks with enough width - Keep signal track around 0.2mm
For: V_{OUT} = V_{ADJ} x (1 + (R23/R24)) = 1.25V x (1 + (40.2kΩ/24.3kΩ)) = 3.3V
Review notes: - Add supplier link for U4, U5 and U6 and all transistors and schotkky diode - Done - Add LED for +3V3 indication - removed from page 4, moved to page 5 - Done - Add a fuse in serial with the battery - Done - In the battery footprint, put more copper on the pins - Will be taken into a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
