pmr7c9/OOS/OOS - optyczny odbiornik sygnalow/OOS - optyczny odbiornik sygnalow.kicad_pcb

## KiCad design OOS - optyczny odbiornik sygnalow/OOS - optyczny odbiornik sygnalow.kicad_pcb (continued)

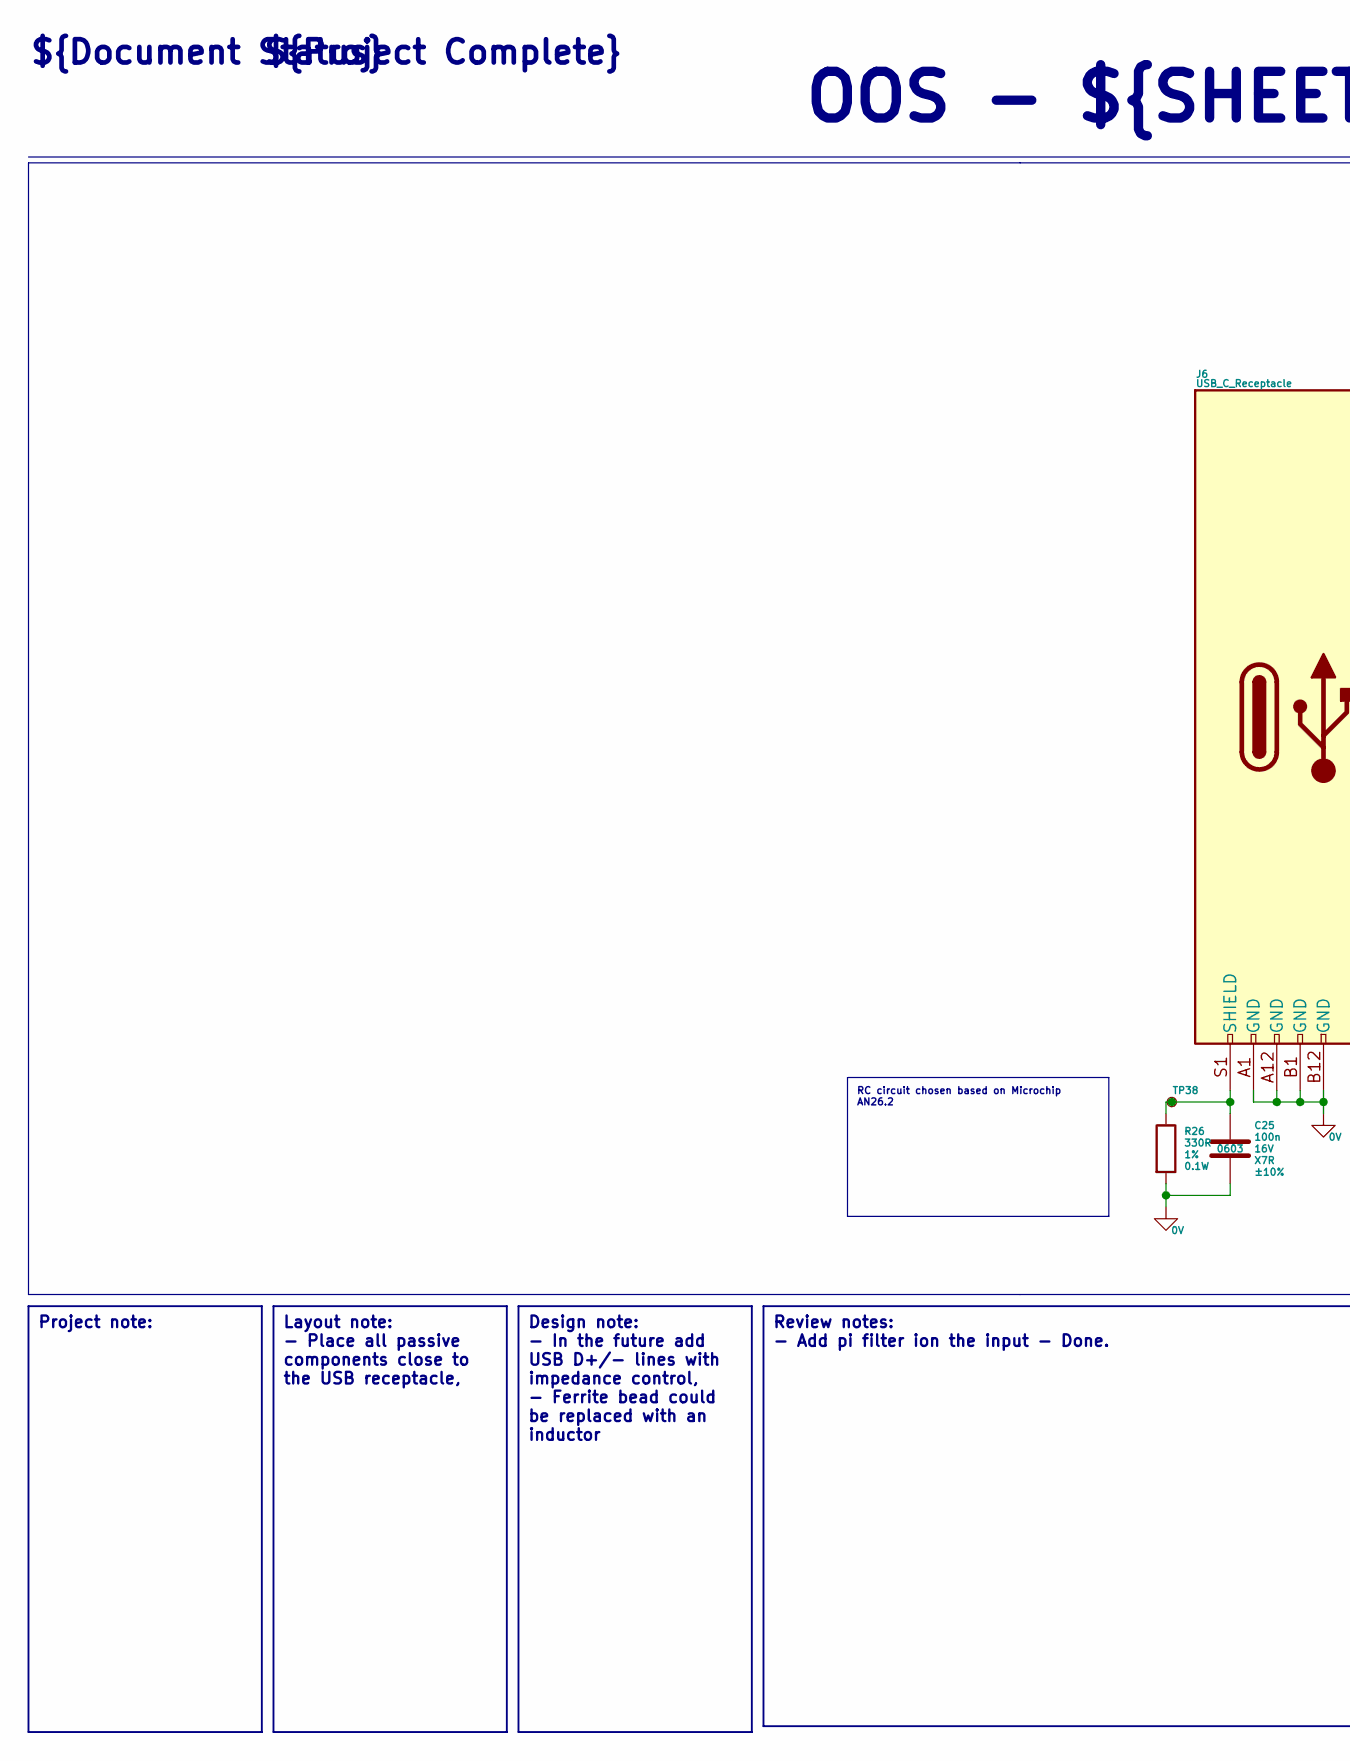
[picture p10: schematic Sekcja_USB.kicad_sch, ${Project Title}, part in row 1, column 1]

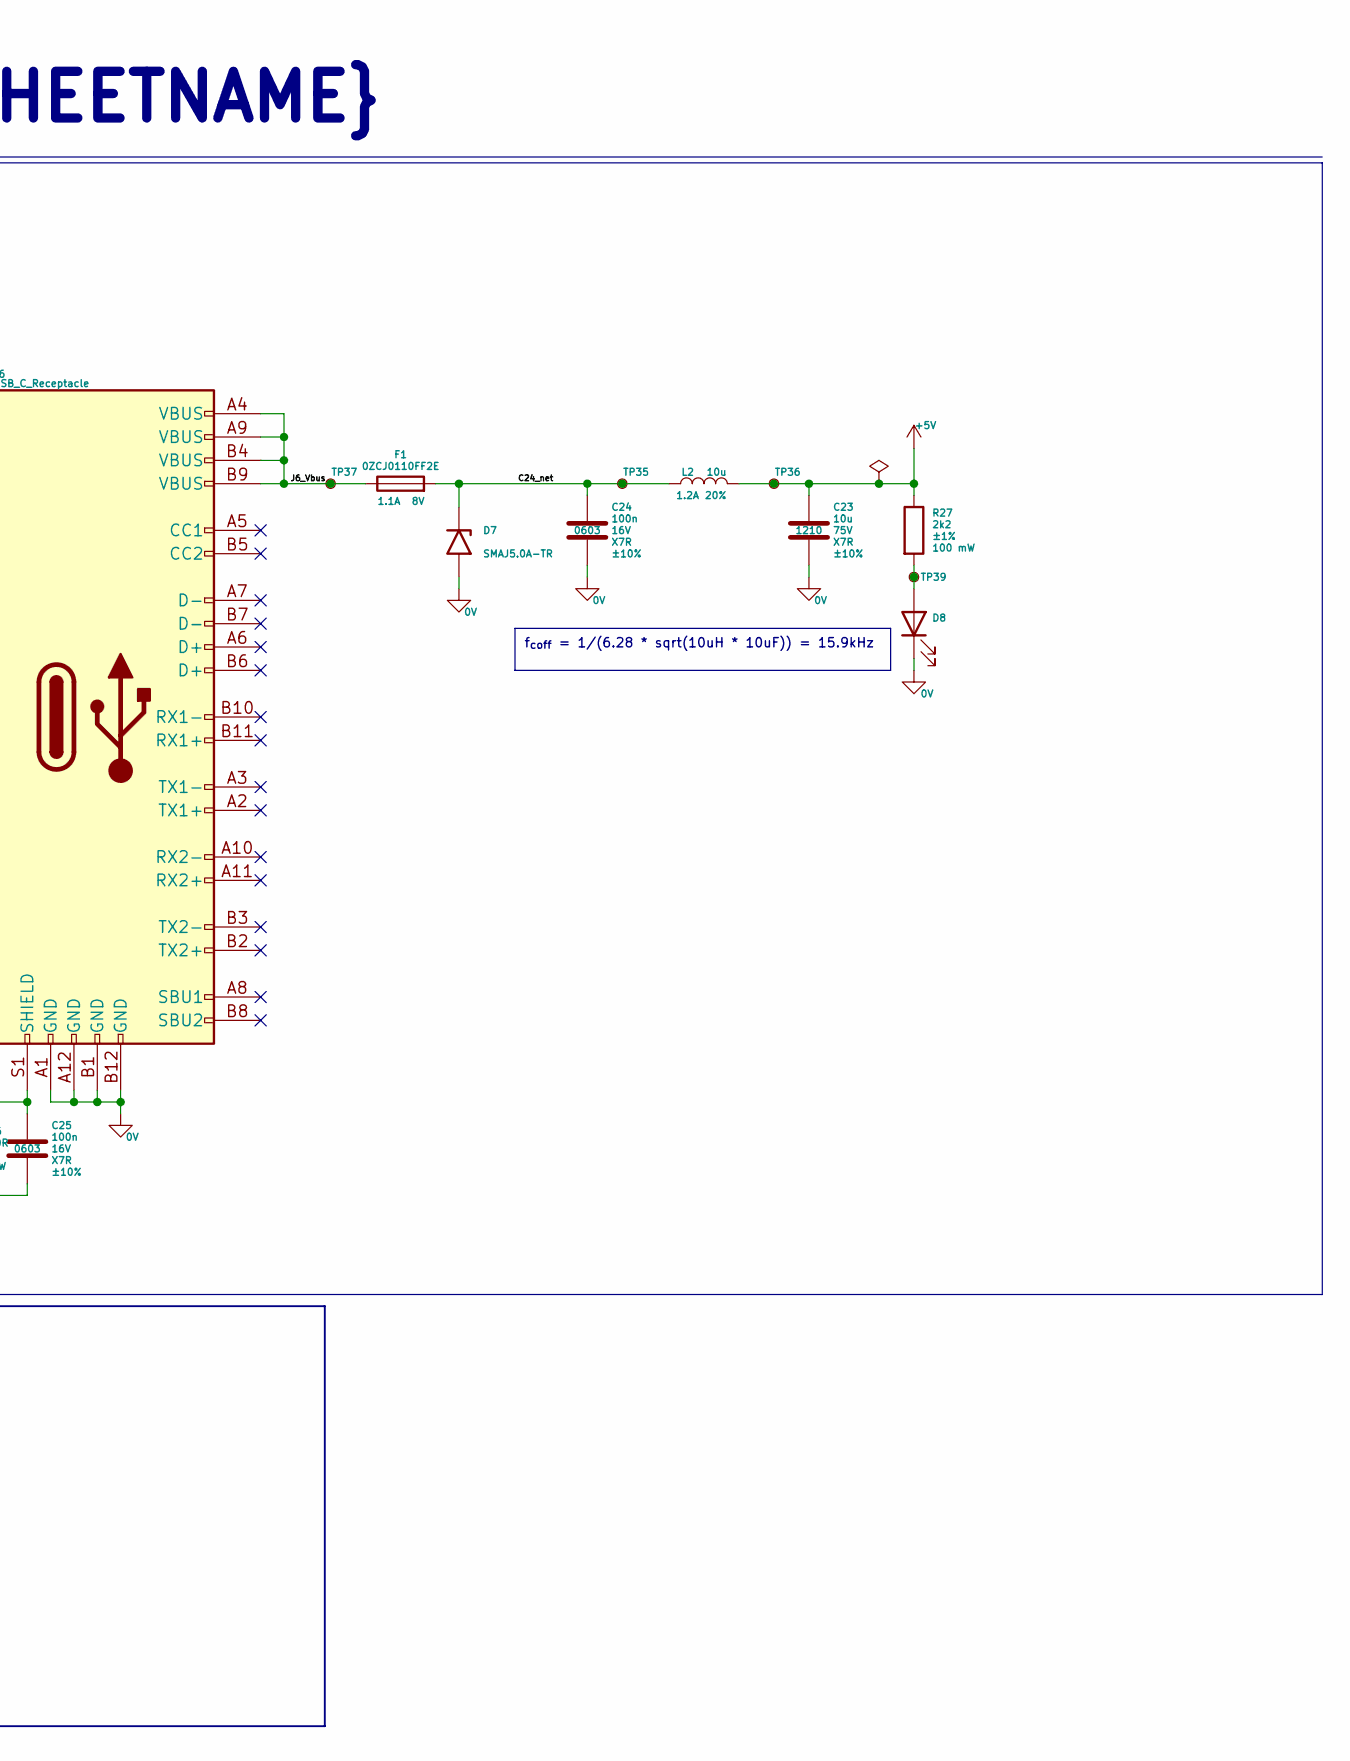
[picture p11: schematic Sekcja_USB.kicad_sch, ${Project Title}, part in row 1, column 2]

Parts:
C23: 10u; C_1210_3225Metric_Pad1.33x2.70mm_HandSolder; Voltage Rating 75V; Tolerance ±10%
C24, C25: 100n; C_0603_1608Metric_Pad1.08x0.95mm_HandSolder; Voltage Rating 16V; Tolerance ±10%; MPN CL10B104KO8WPNC
D7: SMAJ5.0A-TR; D_SMA_Handsoldering
D8: LED; D_0603_1608Metric_Pad1.05x0.95mm_HandSolder; MPN LTST-C191KGKT
F1: 0ZCJ0110FF2E; Fuse_1206_3216Metric; Max Voltage 8V
J6: USB_C_Receptacle; USB_C_Receptacle_Amphenol_12401548E4-2A
L2: 10u; L_Vishay_IHLP-1212; Tolerance 20%
R26: 330R; R_0603_1608Metric; Power Rating 0.1W; Tolerance 1%
R27: 2k2; R_0603_1608Metric_Pad0.98x0.95mm_HandSolder; Power Rating 100 mW; Tolerance ±1%; MPN AC0603FR-072K2L
TP35, TP36, TP37, TP38, TP39: TestPoint_Small; TestPoint_Pad_D1.0mm

Connections:
0V: C23.2, C24.2, C25.2, D7.2 (A2), D8.1 (K), J6.A1 (GND), J6.A12 (GND), J6.B1 (GND), J6.B12 (GND), R26.2; also elsewhere on the board
+5V: C23.1, L2.2, R27.1, TP36.1; also elsewhere on the board
/Sekcja_USB/C24_net: C24.1, D7.1 (A1), F1.2, L2.1, TP35.1
/Sekcja_USB/J6_Vbus: F1.1, J6.A4 (VBUS), J6.A9 (VBUS), J6.B4 (VBUS), J6.B9 (VBUS), TP37.1
unnamed: D8.2 (A), R27.2, TP39.1
unnamed: C25.1, J6.S1 (SHIELD), R26.1, TP38.1

Notes on the sheet:
${Project Complete}
OOS - ${SHEETNAME}
${Document Status}
Review notes: - Add pi filter ion the input - Done.
Layout note: - Place all passive components close to the USB receptacle,
f_{coff} = 1/(6.28 * sqrt(10uH * 10uF)) = 15.9kHz
Project note:
Design note: - In the future add USB D+/- lines with impedance control, - Ferrite bead could be replaced with an inductor
RC circuit chosen based on Microchip AN26.2

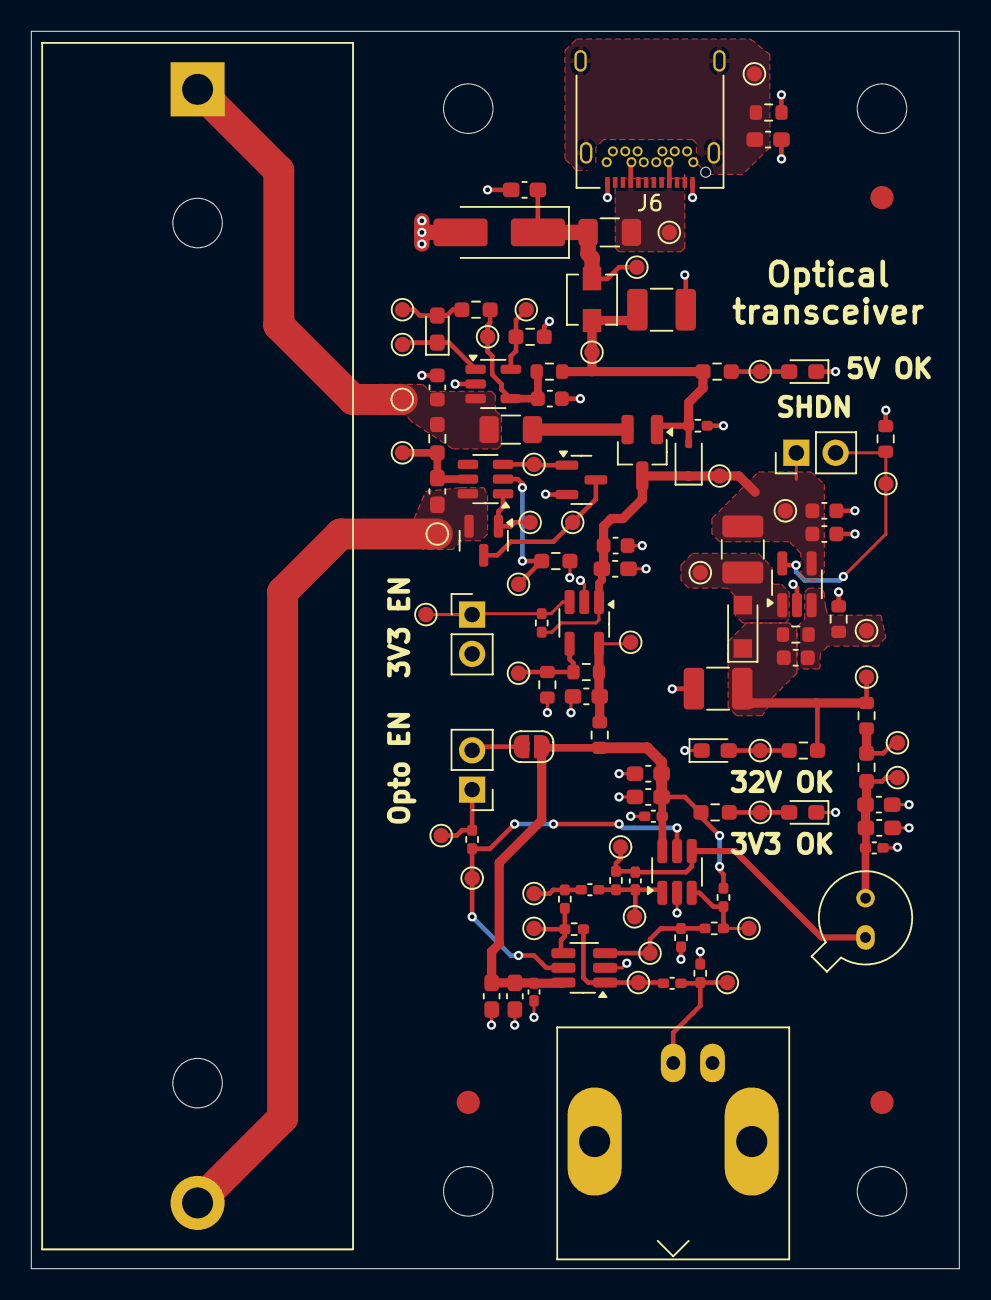
[picture p12: board OOS - optyczny odbiornik sygnalow.kicad_pcb from above]

Board: 2 copper layers, 60.0 x 80.0 mm, 126 parts (0 on the bottom side), 41 nets.
