pmr7c9/OOS/(commit log)

2025-05-22 Solved points from review on page OOS - Analog Part2
    [Sekcja_Analogowa.kicad_sch]
2025-05-28 Add Charging, protection circuit and LDO for +3V3 with passive, transistor and diode components
    [Sekcja_Analogowa.kicad_sch, Sekcja_Li-ion_Ladowanie.kicad_sch]
2025-05-30 Finish Li-Lion section, add for review
    [Sekcja_Analogowa.kicad_sch, Sekcja_DCDC_Boost.kicad_sch, Sekcja_Li-ion_Ladowanie.kicad_sch, Sekcja_USB.kicad_sch]
2025-05-30 Adding review notes for Li-ion battery schematic
    [Sekcja_Li-ion_Ladowanie.kicad_sch]
2025-05-30 Internal changes
    [Sekcja_Li-ion_Ladowanie.kicad_sch]
2025-05-30 Implementing changes after review on Li-Ion section, adding components to USB section
    [Sekcja_Analogowa.kicad_sch, Sekcja_DCDC_Boost.kicad_sch, Sekcja_Li-ion_Ladowanie.kicad_sch, Sekcja_USB.kicad_sch]
2025-05-31 Adding Pi ferrite beat for PI filter on USB, changing RC values for SHIELD pin
    [Sekcja_USB.kicad_sch]
2025-05-31 Adding calciulations for PI filter, moving PI filter after the fuse, replacing ferrite bead with inductor
    [Sekcja_USB.kicad_sch]
2025-06-03 Changing the inductor at USB Pi filter for higher current. Changing the capacitors as well so cutoff frequency is around 15 kHz
    [Sekcja_USB.kicad_sch]
2025-06-03 Creating layout branch, creating a blank pcb file and creating constraints based on JLC PCB capabilities from their website. To every capability lsited a small margin has been added in project constr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
    [OOS - optyczny odbiornik sygnalow.kicad_pcb]
2025-06-04 Adding max board dimentions possible to get 2$ PCBs from JLCPCB. Dimentions will be shrunk as the components are being placed
    [OOS - optyczny odbiornik sygnalow.kicad_pcb, Sekcja_USB.kicad_sch]
2025-06-05 Clean schematic, what left is to add resistors for pull down on usb page and rotary switch on analog page
    [OOS - optyczny odbiornik sygnalow.kicad_pcb, Sekcja_Analogowa.kicad_sch, Sekcja_Li-ion_Ladowanie.kicad_sch]
2025-06-10 All sections except analog are placed (initial placement) on the PCB. Routing not started yet.
    [OOS - optyczny odbiornik sygnalow.kicad_pcb]
2025-06-11 Initial component placement is done. Rotary switch needs to be added and a 4th mount hole placed or removed (to be decided). When selecting resistors for the rotary switch please consider 0402 case d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
    [OOS - optyczny odbiornik sygnalow.kicad_pcb]
2025-06-11 Changing the placement - opamps closer to photodiode, passive components closer to ICs like DCDC converter, Linear 3v3 converter. SHDN resistor moved further away from DCDC and will be routed on the 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
    [OOS - optyczny odbiornik sygnalow.kicad_pcb]
2025-06-11 repeated push
    [OOS - optyczny odbiornik sygnalow.kicad_pcb]
2025-06-11 making opto circuit much tighter
    [OOS - optyczny odbiornik sygnalow.kicad_pcb]
2025-06-11 Move testpoint TP37
    [OOS - optyczny odbiornik sygnalow.kicad_pcb]
2025-06-11 Added polygon for USB3.2, move TP37 on a schematic
    [OOS - optyczny odbiornik sygnalow.kicad_pcb, Sekcja_USB.kicad_sch]
2025-06-11 Moved TP37 on schematic, Added LED diode with resistor for +5V indication, improved component placement for USB3.2
    [OOS - optyczny odbiornik sygnalow.kicad_pcb, Sekcja_USB.kicad_sch]
2025-06-11 Add netclass on schematic and pcb
2025-06-12 trying a different placement for components
    [OOS - optyczny odbiornik sygnalow.kicad_pcb, Sekcja_Li-ion_Ladowanie.kicad_sch, Sekcja_USB.kicad_sch]
2025-06-12 Change on charger side, moved components and place tracks and vias
    [OOS - optyczny odbiornik sygnalow.kicad_pcb]
2025-06-12 Place, route, adjust tracks and components for charger and balancer, create groups
    [OOS - optyczny odbiornik sygnalow.kicad_pcb]
2025-11-27 Zrobiono placement oraz routing. Nalezy jeszcze dodac przelotki do gnd blisko pinow na top layer
    [OOS - optyczny odbiornik sygnalow.kicad_pcb, SR17A1815F89N.stp, Sekcja_Analogowa.kicad_sch]
2025-11-27 Layout finished, need to turn off constraints for USB (J6)
    [OOS - optyczny odbiornik sygnalow.kicad_pcb]
2025-11-28 Zrobiony nieco lepszy layout
    [OOS - optyczny odbiornik sygnalow.kicad_pcb, Sekcja_DCDC_Boost.kicad_sch]
2025-11-28 Dodane napisy na jumperach
    [OOS - optyczny odbiornik sygnalow.kicad_pcb, Sekcja_USB.kicad_sch]
2026-04-22 Add description for OOS device in README
    Added a description of the optical signal receiver device.
